hoopfere/FlyRig/manuals/manual_media/build_flyRig/build_image4.png

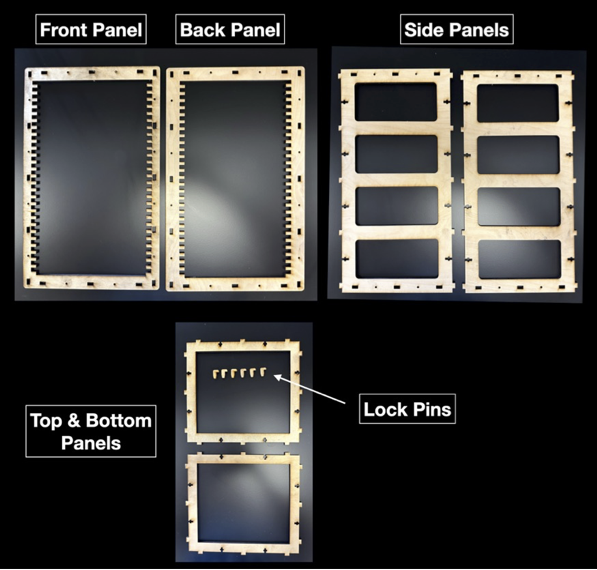
manuals/manual_media/build_flyRig/build_image4.png
