hoopfere/FlyRig/manuals/manual_media/build_flyRig/build_image10.png

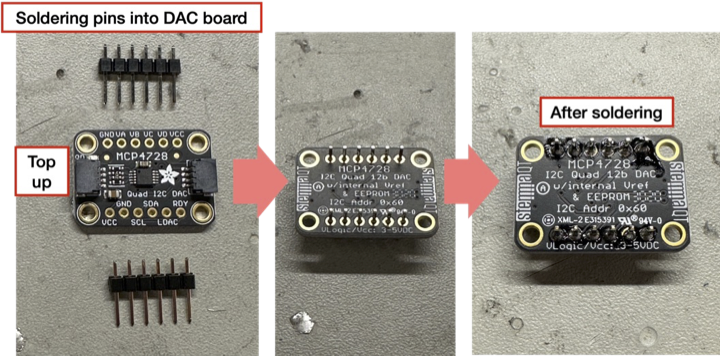
manuals/manual_media/build_flyRig/build_image10.png
