hoopfere/FlyRig/README.md

# FlyRig
Low-cost system for optogenetics in Drosophila
