hoopfere/FlyRig/hardware/FlyRig_DXF_files/ledInsert.dxf

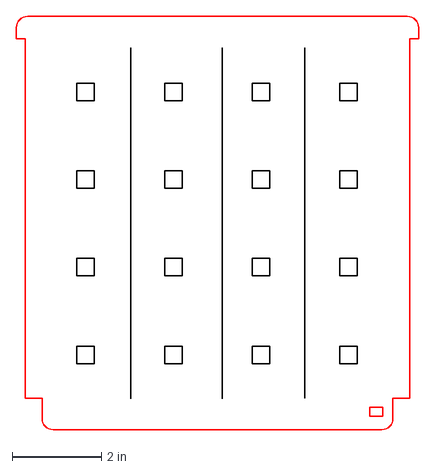
[picture p7: CAD file, 2025-08-15, last stored version]
hardware/FlyRig_DXF_files/ledInsert.dxf
9.02 x 9.27 in
