hoopfere/FlyRig/hardware/FlyRig_DXF_files/backPanel.dxf

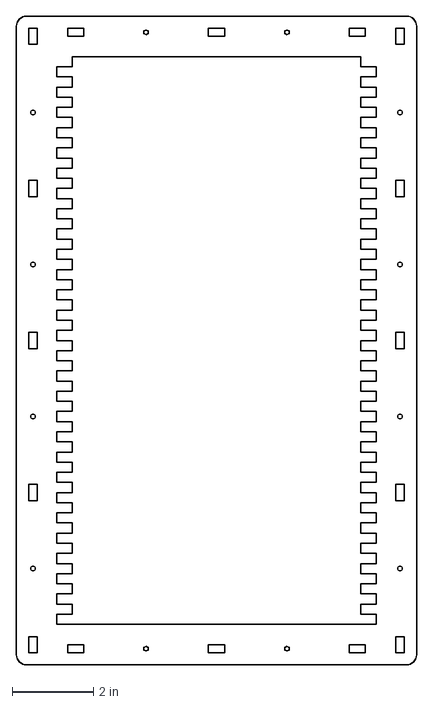
[picture p8: CAD file, 2025-08-15, last stored version]
hardware/FlyRig_DXF_files/backPanel.dxf
9.87 x 16.0 in
