hoopfere/FlyRig/hardware/FlyRig_DXF_files/lockPin.dxf

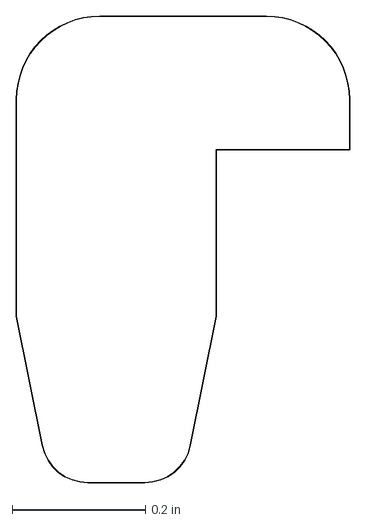
[picture p10: CAD file, 2025-08-15, last stored version]
hardware/FlyRig_DXF_files/lockPin.dxf
0.5 x 0.7 in
