hoopfere/FlyRig/hardware/FlyRig_DXF_files/sidePanels.dxf

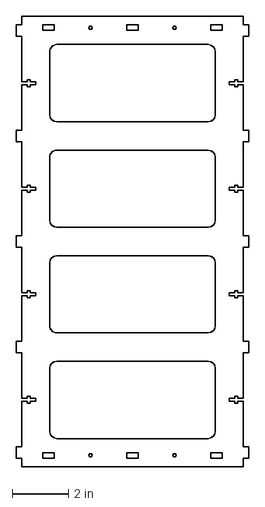
[picture p11: CAD file, 2025-08-15, last stored version]
hardware/FlyRig_DXF_files/sidePanels.dxf
8.27 x 16.0 in
