hoopfere/FlyRig/hardware/FlyRig_DXF_files/frontPanel.dxf

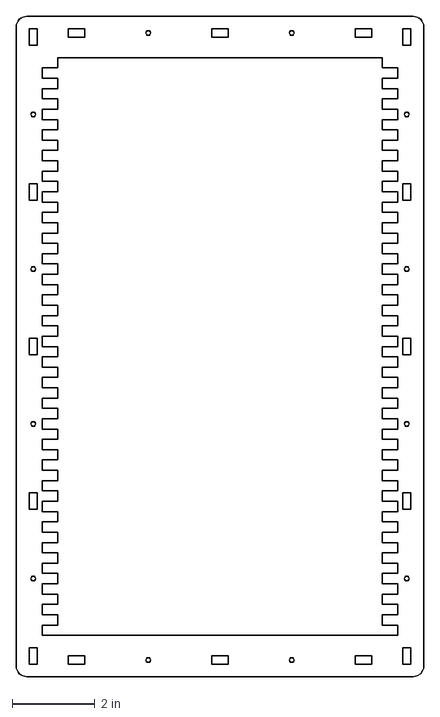
[picture p13: CAD file, 2025-08-15, last stored version]
hardware/FlyRig_DXF_files/frontPanel.dxf
9.87 x 16.0 in
