hoopfere/FlyRig/hardware/FlyRig_DXF_files/topBottom.dxf

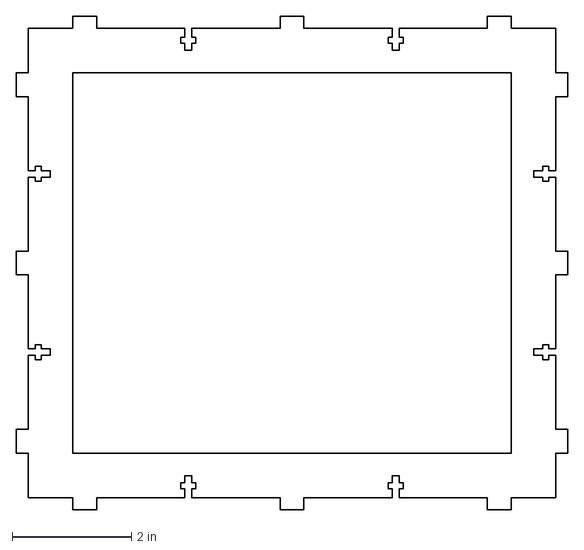
[picture p14: CAD file, 2025-08-15, last stored version]
hardware/FlyRig_DXF_files/topBottom.dxf
9.25 x 8.27 in
