hoopfere/FlyRig/manuals/Building_FlyRig.docx

# Building FlyRig

# Introduction

The Optogenetics FlyRig is a system to do optogenetic behavioral experiments with fruit flies. The system was designed by Eric Hoopfer and Aaron Heidgerken-Greene at Carleton College. The goal of this system is to provide a simple and flexible system that can be implemented with minimal cost and technical expertise.

Current versions of parts files, software code, and instruction manuals are located at https://github.com/hoopfere/FlyRig/wiki.

# The system

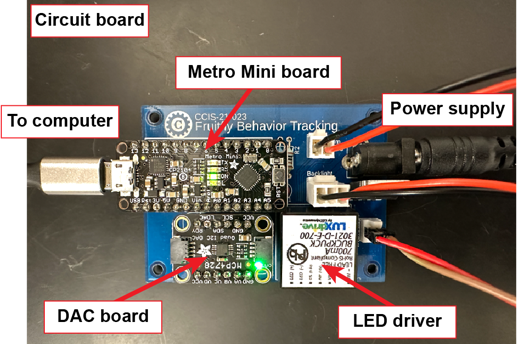
[picture p19: figure]

The FlyRig system has three main components: the photostimulation rig, circuit board, and FlyRig software. The software runs most stably in a Windows environment, although it can be run on Macs.

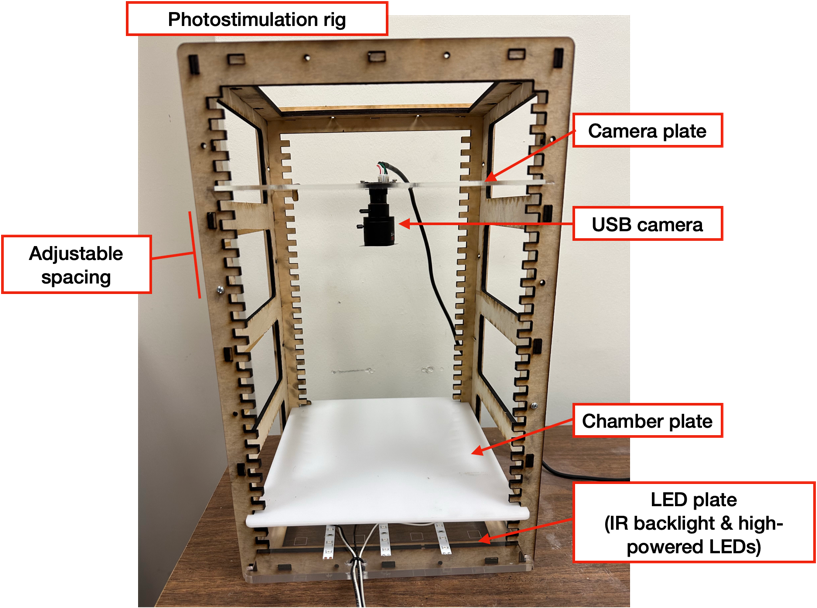
[picture p20: figure]
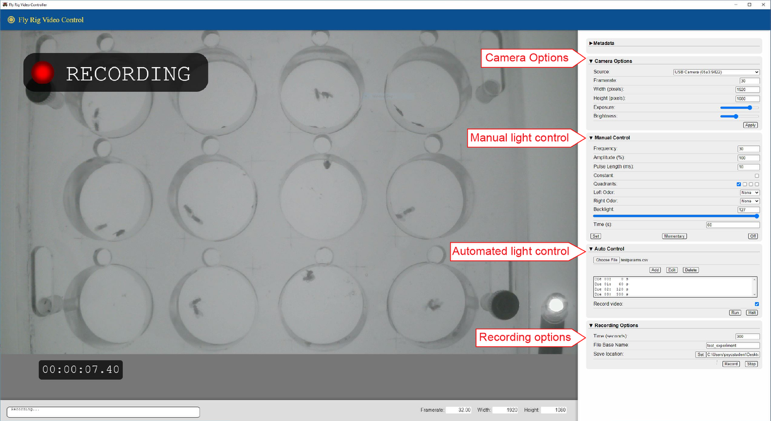
[picture p21: figure]

# Assembling the Photostimulation Rig

## 1. Laser cut parts

  a. The following parts should be cut on a laser cutter.

Part | Quantity | Material
frontPanel¹ | 1 | 3/16” nominal plywood
backPanel | 1 | 3/16” nominal plywood
sidePanels | 2 | 3/16” nominal plywood
topBottom | 2 | 3/16” nominal plywood
lockPin | 3-6 | 3/16” nominal plywood
ledInsert² | 1 | 1/8” acrylic
arenaInsert | 1 | 1/8” white Delrin
cameraInsert | 1 | 1/8” acrylic or delrin

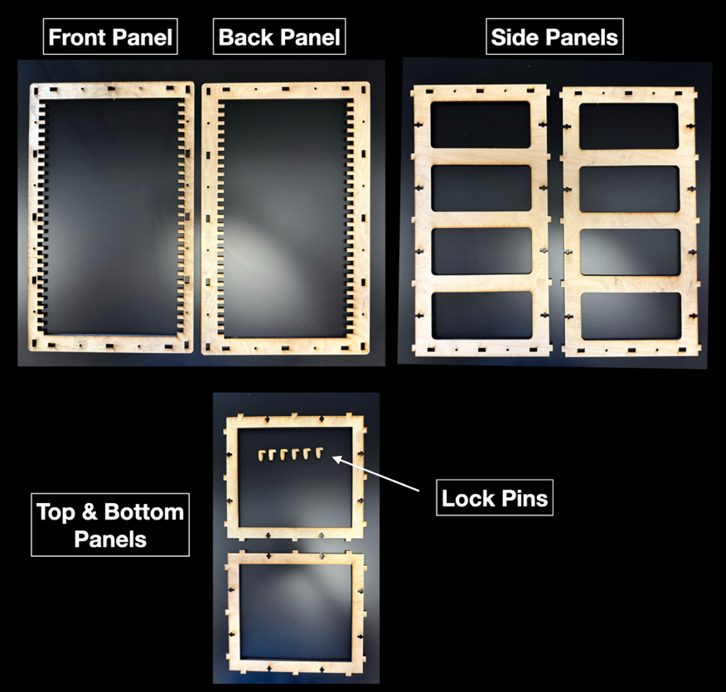
[picture p22: figure]

Note 1: Wood parts can be cut from acrylic or Delrin to aid in cleaning. If so, the material should be 0.2” thick to fit in the slots.

## 2. Assemble the structure

  a. Assemble the top and bottom panels into the side panels.
  b. Assemble the front and back panels.

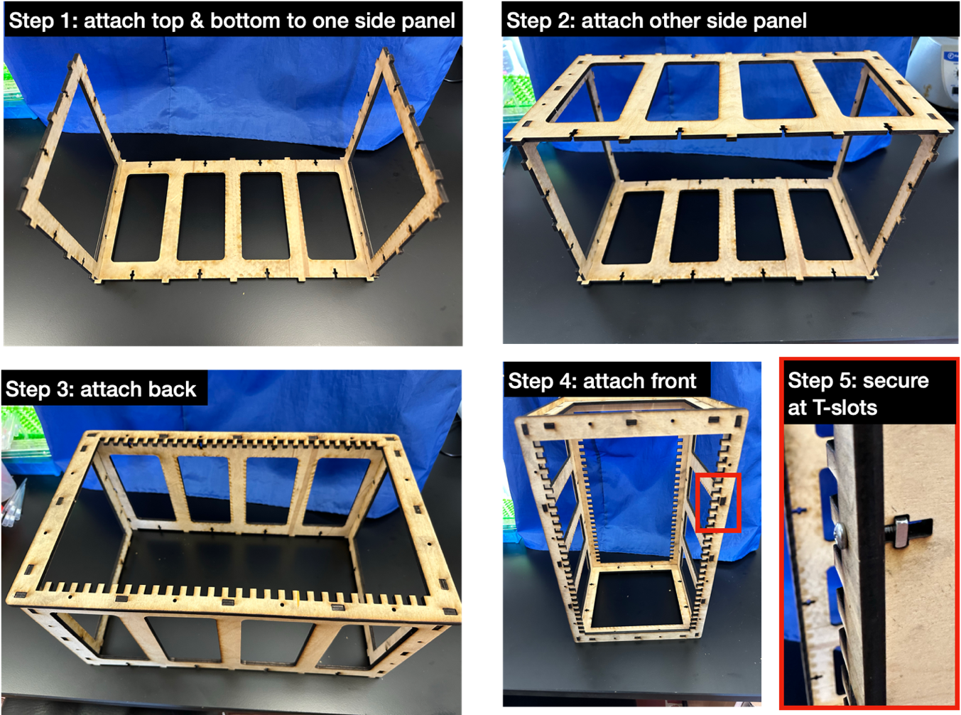
[picture p23: figure]

  c. The panels can be joined at T-slots using ½” 4-40 screws and square nuts or glued together.

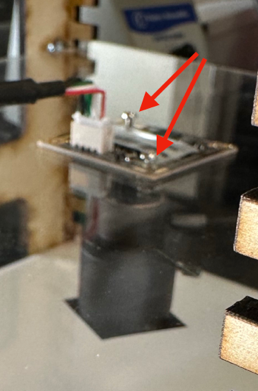
[picture p24: figure]

  d. Screw camera into cameraInsert plate.
  e. Cut a piece of IR filter to match the size of the camera lens and affix it to the lens with glue.
  f. The rig is designed to allow flexibility in the distance between the LED, chamber, and cameral plates. Insert the plates in the shelves and use the lock pin to keep the plates in place.

# 3. Assemble LED plate

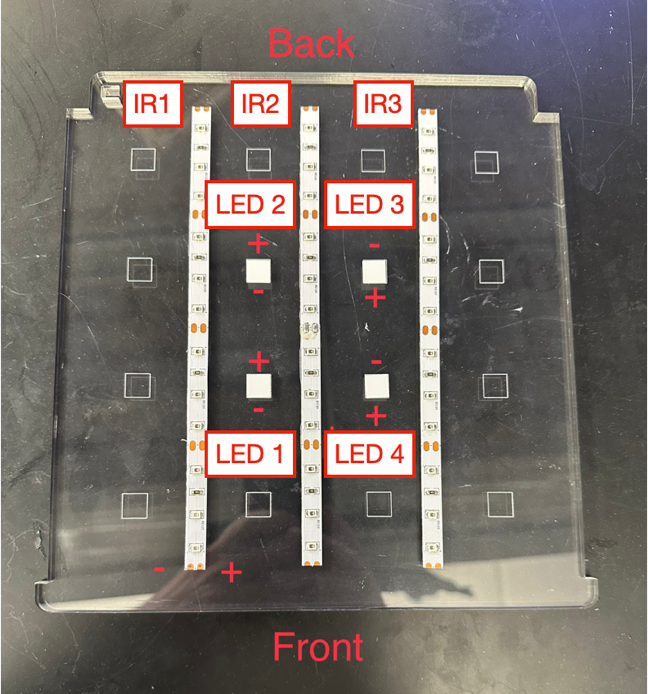
[picture p25: figure]

## 3.1 Attach LEDs to the plate

  a. The LED plate is etched with three lines to guide the placement of the IR LED strips and squares where high-powered LEDs can be placed.
  b. Cut three 20cm IR LED strips and affix them along the lines on the plate. Only cut the LED strips in the middle of the solder pads.
  c. Affix the thermal stickers for the 10mm LEDs on the four squares in the center of the plate. Optionally, you can drive up to 8 LEDs with one circuit board. Circuit boards are available that allow independent control of 4 sets of LEDs, allowing for light control in different areas or multiple wavelengths of LEDs to be used.
  d. Affix the LEDs to the thermal stickers using constant pressure on the base of the LED for about 30 sec.

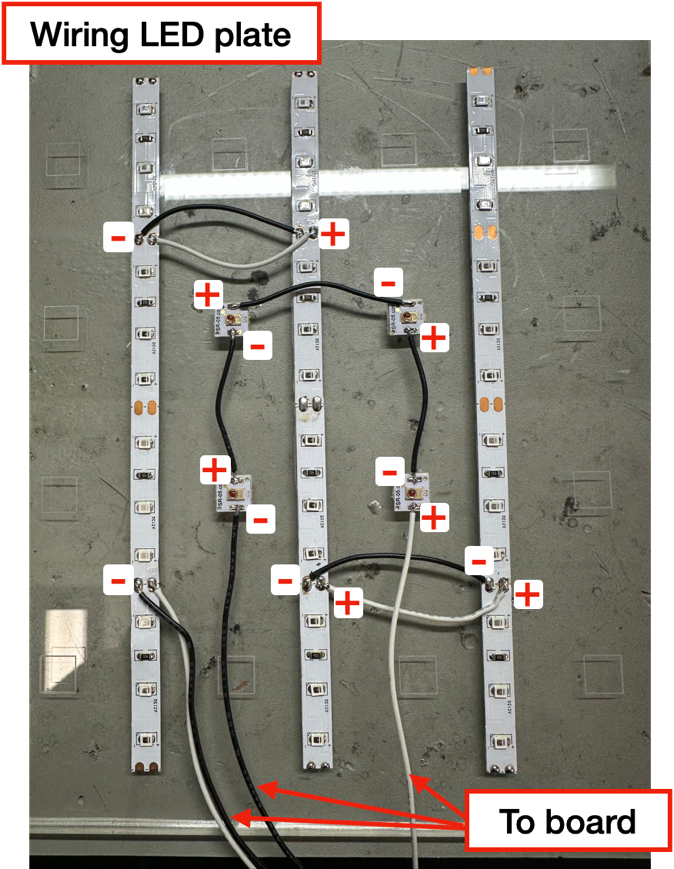
[picture p26: figure]

Attention! The high-powered LEDs will be connected in series. Place them so that the positive pad of one faces the negative pad of the next one, as shown below.

## 3.2 Wire the LEDs

  a. Connect the IR LED strips in parallel.
  b. Connect positive to positive and negative to negative as shown below.
  c. Cut 2’ lengths of wire (red and black) to run from IR strips to the circuit board and solder to pads on the IR1 strip. Solder the red wire to the positive pad and the black wire to the negative pad.
  d. Connect the high-powered LEDs in series.
  e. Beginning with LED1, connect its positive pad to the negative pad of LED2 with a piece of wire. Repeat with LED2 to LED3 and LED3 to LED4.
  f. Cut 2’ lengths of wire to run from LED strips to the circuit board. Solder the black wire to the negative pad on LED1 and the red wire to the positive pad on LED4.

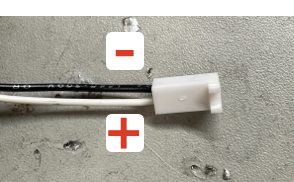
[picture p27: figure]

  g. Attach female connectors to wires.
    - Solder each wire onto the wire crimps.
    - The high-powered LED wires should be connected to the 2-pin connector and the IR LED wires should be connected to the 3-pin connector.
    - Insert the wires into the connectors as shown below.
h. Solder wires to the indicator LED (an infrared LED) and solder onto wires crimps for a 2-pin connector (same as high-powered LED wires).

## 4. Assemble the circuit board

## a. Solder pins into Adafruit Quad DAC board (MCP4728)

    - Cut down the pin strip to 6 pins (as shown).
    - Insert the short end into the bottom of the board.

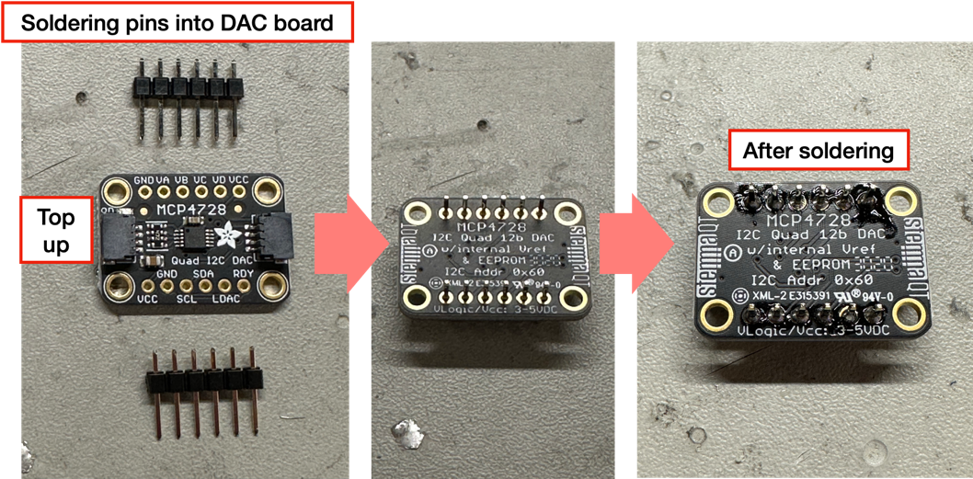
[picture p28: figure]

    - Flip the board over so it faces up and solder the pins to the top of the board.
  b. Solder pins into the Adafruit Metro mini board
    - Cut down the pins strip to 14 pins.
    - Repeat the same procedure that you used for the DAC board.
  c. Solder the header connectors to the circuit board
    - Note: It is easiest to first connect the header connectors to the two Adafruit boards and then insert the pins of the connectors into the board. This ensures that header pins are correctly aligned and makes soldering easier.
    - Insert two rows of header connectors into the corresponding board slots on the Metro Mini and DAC board spaces on the circuit board.
    - Lightly tape down the components to the top of the board to hold them in place.
    - Flip the board over and solder the pins to the bottom of the board.

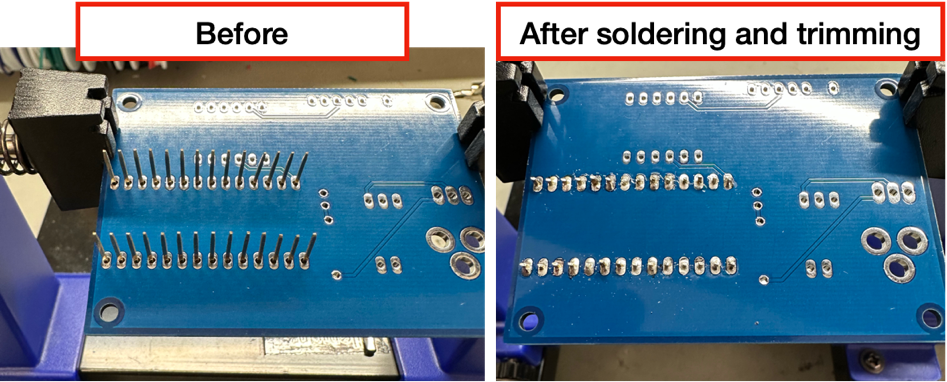
[picture p29: figure]

    - Trim the excess pins with the wire cutters.

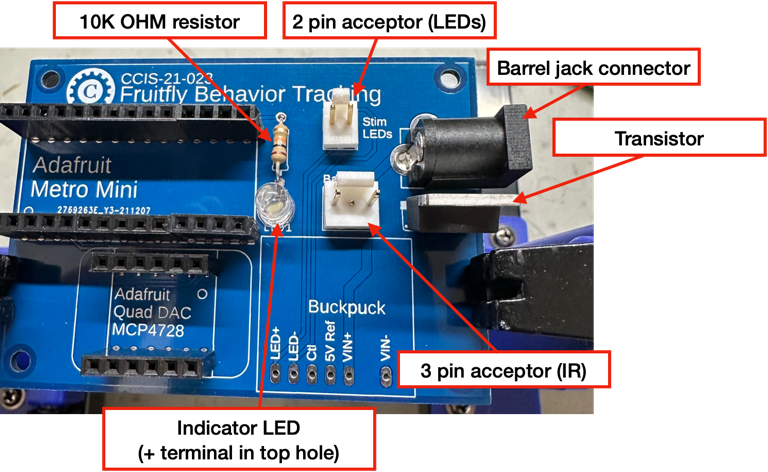
[picture p30: figure]

  d. Solder the remaining components into the board as shown below except for the LED driver

Note: The long wire of the indicator LED is the positive terminal. This should go into the upper slot on the board.

  e. Lastly, solder the LED driver to the board.

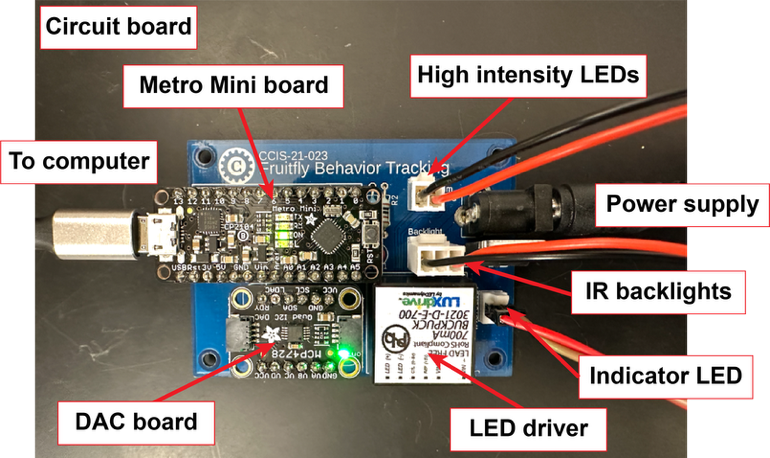
[picture p31: figure]

5. Download and Install FlyRig Software

Option 1: Windows (executable)

  a. Download the latest executable version of FlyRig (here (https://github.com/hoopfere/FlyRig/blob/main/software/FlyRig%201.6.0.exe)).

Option 2: Windows (source code)

a. Install LTS version of nodejs (https://nodejs.org/en/).
  - When prompted, click on the box that says “Automatically install…”
  - After installing, another window will appear asking whether to install additional tools. Press any key to continue (you’ll have to do that twice).
  - It should then open a Windows PowerShell window and start installing Visual Studio (this can take a bit).
b. Download git for Windows (64 bit setup) https://git-scm.com/download/win
  - Select default on all install steps. It will ask you to install additional packages -- do so
c. Launch nodejs “command prompt” not “nodejs”. The the following commands at the prompt and hit Return after each.
- cd Documents
- mkdir FlyRig
- cd FlyRig
- git clone https://github.com/CC-IS/CCIS-2020-011-FlyRig.git
- cd ~/Documents/FlyRig/CCIS-2020-011-FlyRig
- npm install

Option 3: Mac (source code)

a. Download node (nodejs.org/en/download)
b. Open the Terminal and type the following commands and hit Return after each.
- cd Documents
- mkdir FlyRig
- cd FlyRig
- git clone https://github.com/CC-IS/CCIS-2020-011-FlyRig.git
c. Make sure you are in the /Documents/FlyRig/CCIS-2020-011-FlyRig folder before typing: npm install
6. Install Silicone Labs driver
a. Download and install Silicone Labs COM port driver (https://www.silabs.com/documents/public/software/CP210x_Universal_Windows_Driver.zip).
b. Open the Device Manager, click “Update driver” on the Silicone Labs device, and browse to the unpacked zip folder that was downloaded.
c. Restart your computer
7. Load Arduino code onto the circuit board
  a. Download Arduino (https://www.arduino.cc/en/software) software.
  b. Download the following Arduino files here (https://github.com/CC-IS/CCIS-2020-011-FlyRig/tree/25ce5046805b52be34f6a6d21ddb878376a71f90/arduino%20program/lightController) and extract them. You should have 3 files:
    - lightController.ino
    - serialParse.h
    - timeOut.h
  c. Connect the Arduino Metro Mini board to the computer with the Micro USB cable.
  d. Select the correct port for the board: Tools>Port.
  e. Launch the Arduino program and open the lightController.ino file.
  f. Verify the code by clicking on the “check” button in the upper left corner.
    - You may need to install the following Arduino libraries:
    - When you see “Done” at the end, you can proceed to upload the code to the board.
  g. Upload the code by clicking on the “→” button in the upper left corner.
  h. Your board is now ready to use!

Note: The most common error you will encounter is if the wrong port was selected for the board. Select a different port and try uploading again.

8. Assemble the system
  a. Connect the camera to the computer.
  b. Connect the Adafruit Metro Mini to the computer (if not already connected).
  c. Plug the LED, IR, and indicator LEDs into the board.
  d. Connect the power supply.
  e. Launch the FlyRig software.

Note: If the power supply is connected but the Metro Mini board is not, the LEDs will remain on at full intensity.

9. Start FlyRig

Windows executable version

- Double-click on FlyRig.exe icon

Window (source code)

- Launch nodejs “command prompt” and type:
- cd ~/Documents/FlyRig/CCIS-2020-011-FlyRig
- npm start

Mac (source code)

- To run FlyRig, open a terminal window and type:
  - cd Documents/FlyRig/CCIS-2020-011-FlyRig
  - npm start
