hoopfere/FlyRig/manuals/manual_media/build_flyRig/build_image11.png

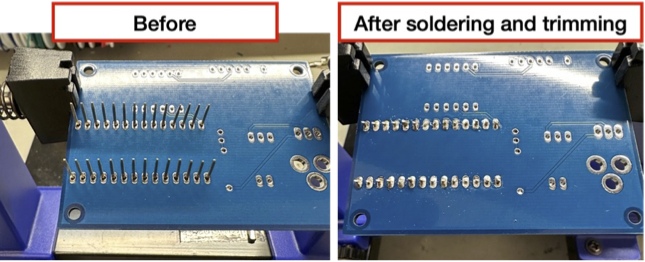
manuals/manual_media/build_flyRig/build_image11.png
