hoopfere/FlyRig/(commit log)

2025-08-15 added supplemental files
    classifiers, example movies and score files, dfx files, executable, how-to video
    [Line1_scores.xlsx, Line2_scores.xlsx, Line3_scores.xlsx, Line4_scores.xlsx, arenaInsert.dxf, backPanel.dxf, cameraInsert.dxf, frontPanel.dxf]
2025-08-15 reorganized files
    [Line1_scores.xlsx, Line2_scores.xlsx, Line3_scores.xlsx, Line4_scores.xlsx, arenaInsert.dxf, backPanel.dxf, cameraInsert.dxf, frontPanel.dxf]
2025-08-15 updated dfx file location
    [arenaInsert.dxf, backPanel.dxf, cameraInsert.dxf, frontPanel.dxf, ledInsert.dxf, lockPin.dxf, sidePanels.dxf, topBottom.dxf]
